sudonautilus71/MidiFaderMotorizado/README.md

Controlador MIDI con Fader Motorizado Descripción del Proyecto 
Este es un proyecto de hardware y software para un controlador MIDI que incluye: 
Fader motorizado para un control preciso y automatizado.
Pantalla LCD para retroalimentación visual.
Encoder rotativo y botones para ajustes y navegación.
Funcionalidades específicas como control de panorama, navegación de pistas, zoom horizontal/vertical, y más.

Características Principales 
PAN: Ajusta el panorama de la pista seleccionada.
TRACK: Cambia entre pistas del proyecto.
RW/FF: Control de avance/retroceso en la línea de tiempo.
ZOOM H/V: Control de zoom horizontal y vertical.
Encoder: Envío de valores incrementales o decrementales.
Opciones futuras: Funcionalidades adicionales en desarrollo.

Requisitos 
Hardware:
Controlador MIDI con fader motorizado (este proyecto).
Cable USB.
Software:
DAW compatible con MIDI.
Herramientas para carga de firmware (opcional, si necesitas modificar el código).
Entorno:
Sistema operativo Windows, macOS o Linux con soporte MIDI.

Instalación 
Conectar el dispositivo:
Conecta el controlador MIDI al puerto USB de tu computadora.
Verifica que el sistema detecte el dispositivo.
Configurar en el DAW:
Abre tu DAW preferido.
Configura el controlador MIDI en la sección de dispositivos.
Asigna las funcionalidades a los controles deseados, si es necesario.

Modo de Uso 
Encender el dispositivo y calibrar el fader (automático).
Usar los controles para interactuar con el software:
PAN, TRACK, RW/FF, ZOOM H, ZOOM V: Funcionalidades integradas (ver manual).
ENCODER: Ajustes incrementales de parámetros asignados.
Botones adicionales: Reservados para configuraciones personalizadas.

Archivos del Repositorio 
conexines v1.pdf
manual v1.pdf
fadrport v1.ino

Contribui
