sudonautilus71/MidiFaderMotorizado/conexiones v1.pdf

# LCD I2C

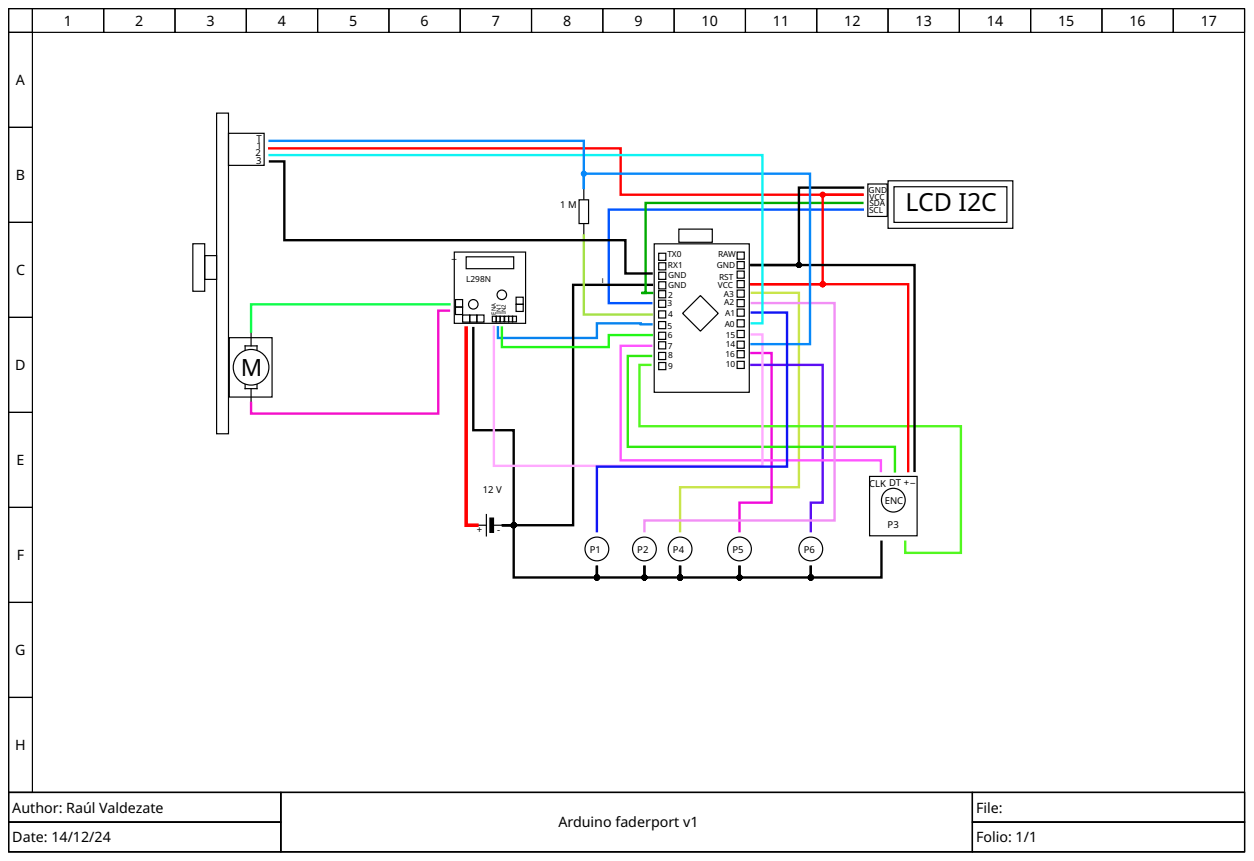
[picture p3: page 1]
Arduino faderport v1; File:; Date: 14/12/24; Folio: 1/1; GND; VCC; RST; RAW; GND SDA; VCC SCL; ENA; ENC; CLK

Author: Raúl Valdezate
